wifly-uav/document/装置/ハイスピードカメラ.md

# ハイスピードカメラ

FASTCAM SA3 model 120K-M2の使い方

## インストール

1. [Photronのページ](https://photron.com/photron-support/
)からPFV4をダウンロードする。
Google DriveでもZipでもOneDriveでも良い。
2. ダウンロードしたものがZipの場合、展開する。
3. PFV4_DVDImage(V4.0.6.2)\PFV4_DVDImage(V4.0.6.2)\PFV Setup64を起動する
32bitの場合は、Setup32だが分からない場合はSetup64で良い
windows以外は恐らく不可 
4. 画面に従ってPFV4をインストール
5. ネットワークの設定して再起動

## 撮影手順

1. Boxからカメラとレンズを取り出す
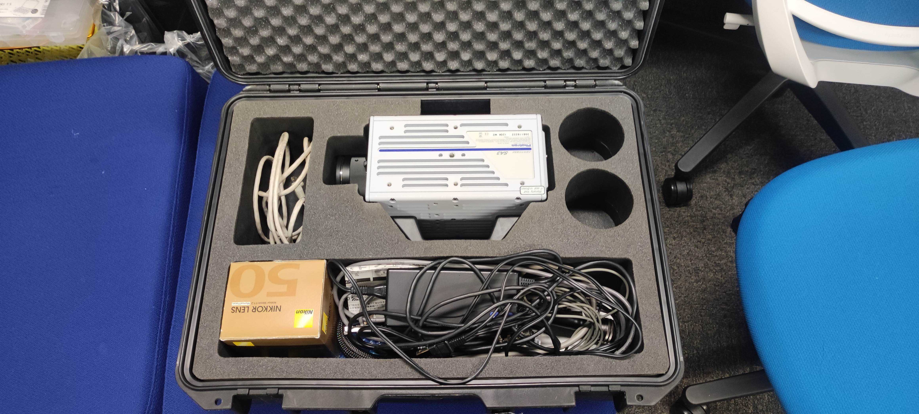
[picture p10: 装置/img/camera_box.jpg]

Boxの開けた状態
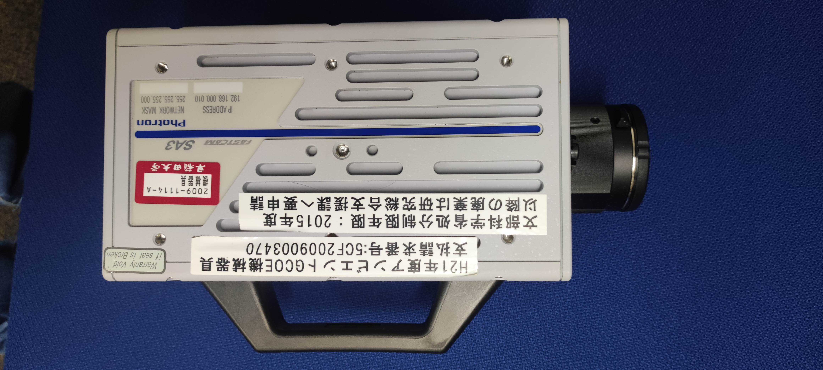
[picture p11: 装置/img/camera_hontai.jpg]

カメラ本体
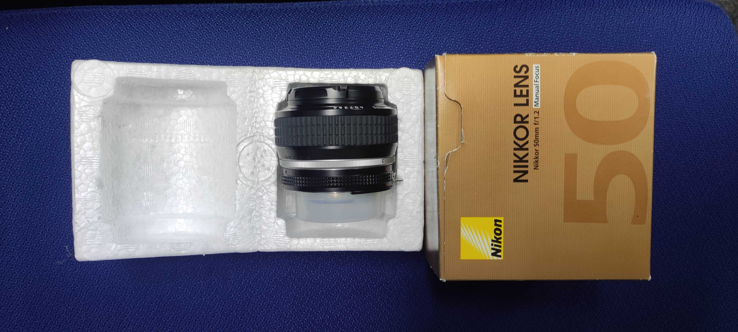
[picture p12: 装置/img/renzu.jpg]

レンズ

2. カメラにレンズを取り付ける
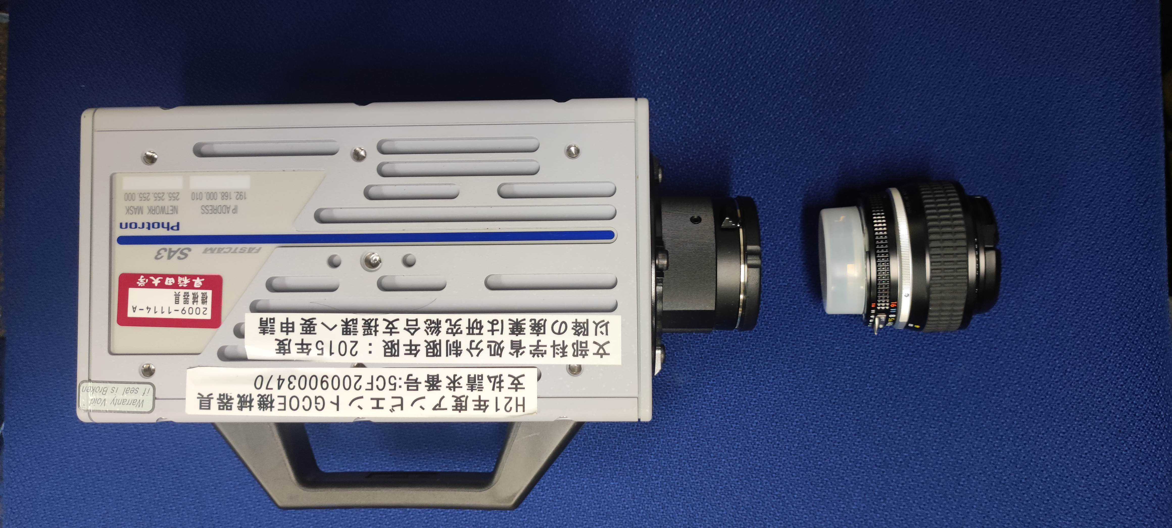
[picture p13: 装置/img/joint.jpg]

まず、レンズ側の白い部分を取り外す。次に、カメラ本体の黒いキャップを外す。最後にレンズをカメラ本体に取り付ける。取り付けるときは回転させてカチッと音が鳴るまで。
**カメラ本体とレンズについてキャップを取り外している状態で中に埃等が入ると使い物にならなくなるので注意**
取り付けると以下のようになる。
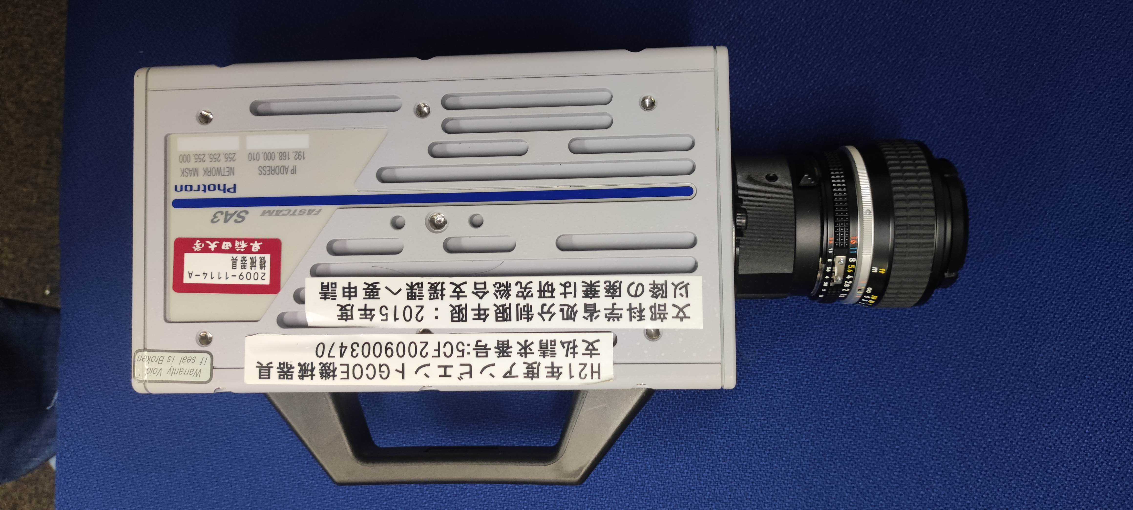
[picture p14: 装置/img/camera.jpg]

レンズを取り外す時はカメラの先端の黒い部分を押しながらレンズを回転させると外すことができる。

3. 設置する
カメラ本体を安定した所に設置する。基本的には、三脚の上に固定をおすすめする。ただし、固定はねじ一本なのでちゃんと固定できたか確認すること。
ハイスピードカメラタカイヨ

4. 配線する
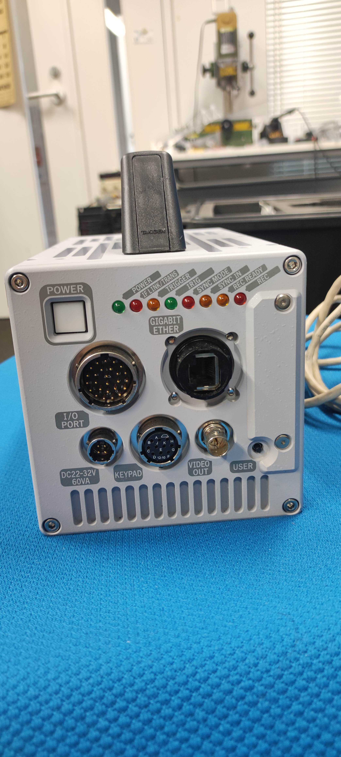
[picture p15: 装置/img/camera_haimen.jpg]

カメラの裏側がこのようになっているので以下のように電源とLANケーブルを配線する。
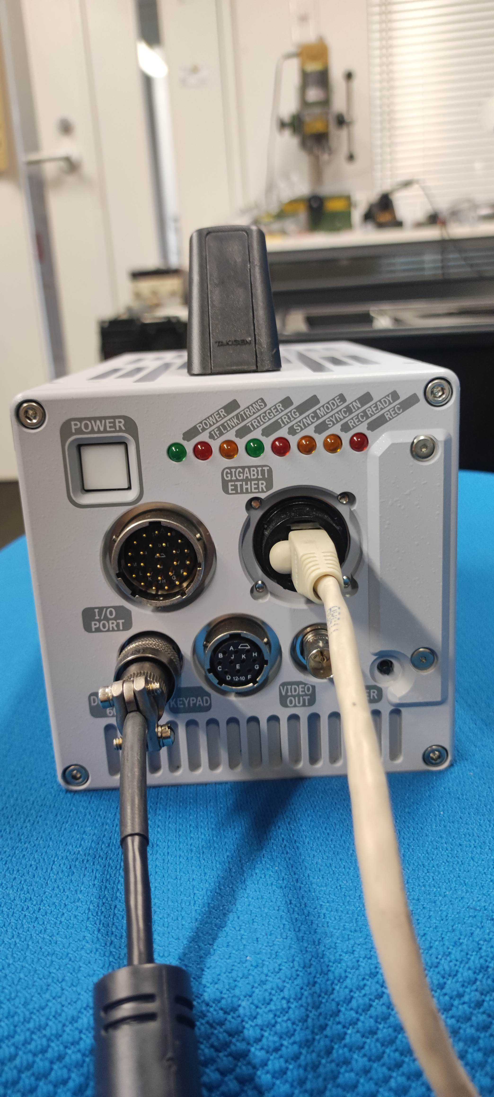
[picture p16: 装置/img/camera_haisen.jpg]


5. カメラの電源を付ける
背面左上の白いボタンを押すと電源が入る。電源を入れておくとカメラ本体が徐々に熱くなっていくので注意。

6. LANケーブルをパソコンに接続する
7. PFV4を起動する
起動した際にカメラが見つからないといった内容のエラーが出てくることがある。その場合は、エラー画面からネットワーク最適化を開く。
192.168.0.1
255.255.255.0
(たぶん最初からこの値が入ってる)
でイーサネットに割り当てを行う。
その後、PFV4を再起動するとちゃんと起動できる。
起動すると以下のような画面になる。
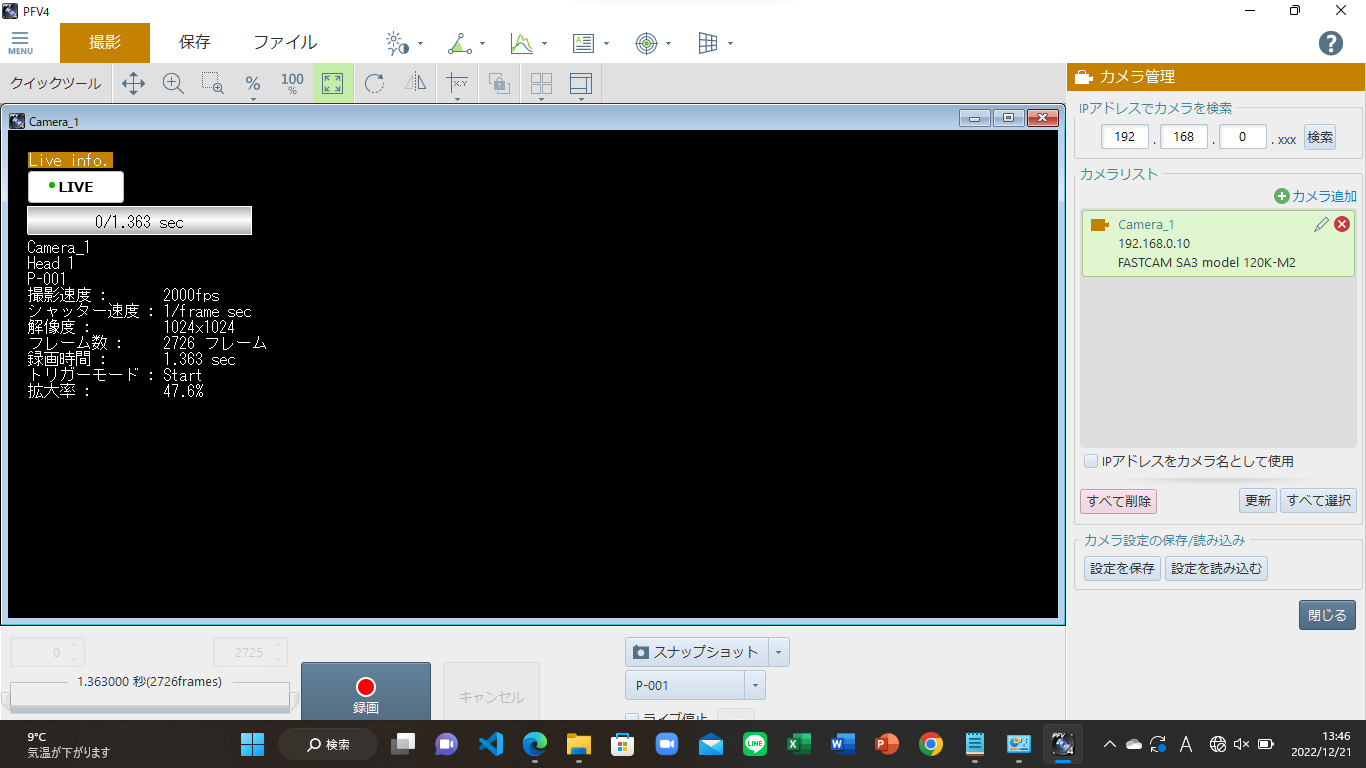
[picture p17: 装置/img/camera_home.png]

ハイスピードカメラを使用後、LANケーブルを使ってインターネットに繋ごうとするとエラーが起きることがある。その時は、windows画面右下のインターネット接続状況を表すアイコンを右クリックし、修復を行うことでインターネットに接続できるようになる。

8. カメラのレンズに付いてるキャップを取り外す
レンズをいじってピントと明るさを調整する。明るさはMAXで良い。

9. 撮影する
画面右下の録画を押すと以下のような待機画面になる。
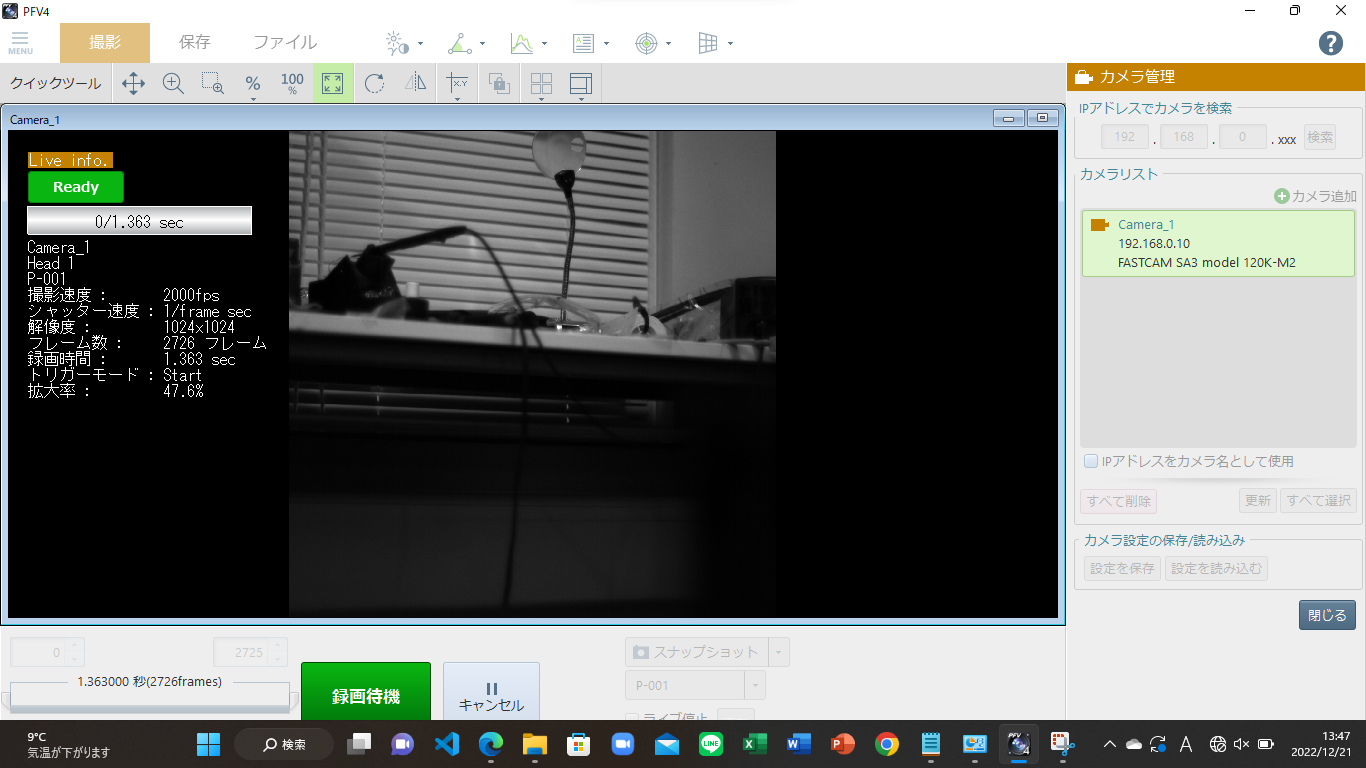
[picture p18: 装置/img/capture2.png]

この状態から右下の録画待機ボタンを押すと撮影できる。
初期設定では、恐らく3秒間撮影される。基本的に3秒以上は撮影できず、それ以上撮影したい場合は解像度を落とせば良い......はず。

10. 保存する
撮影が終了すると自動的に以下のような画面になる。
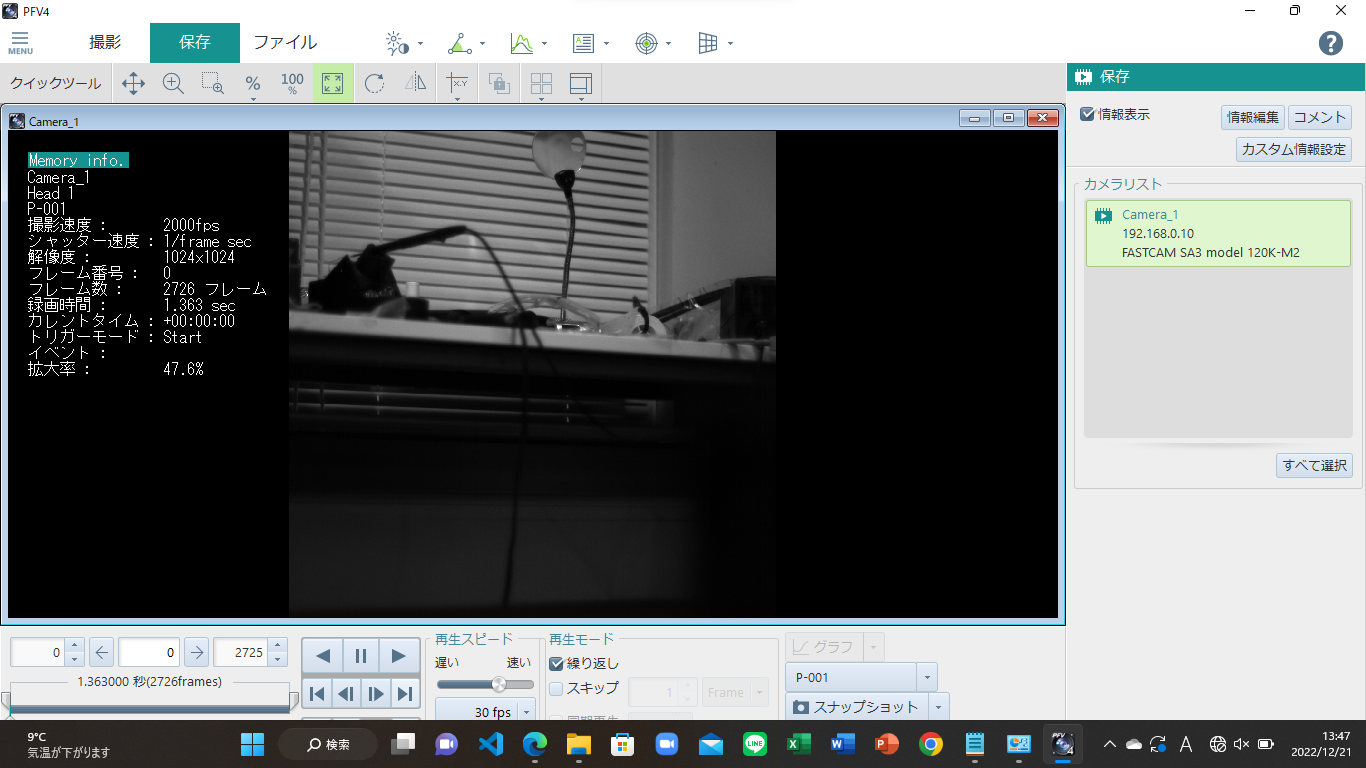
[picture p19: 装置/img/capture1.png]

この画面で操作すると撮影した動画を再生できる。保存したいときは右下（このキャプチャだとタスクバーで隠れてる）のボタンを押す。
ボタンを押すと以下のような画面が出てくる。
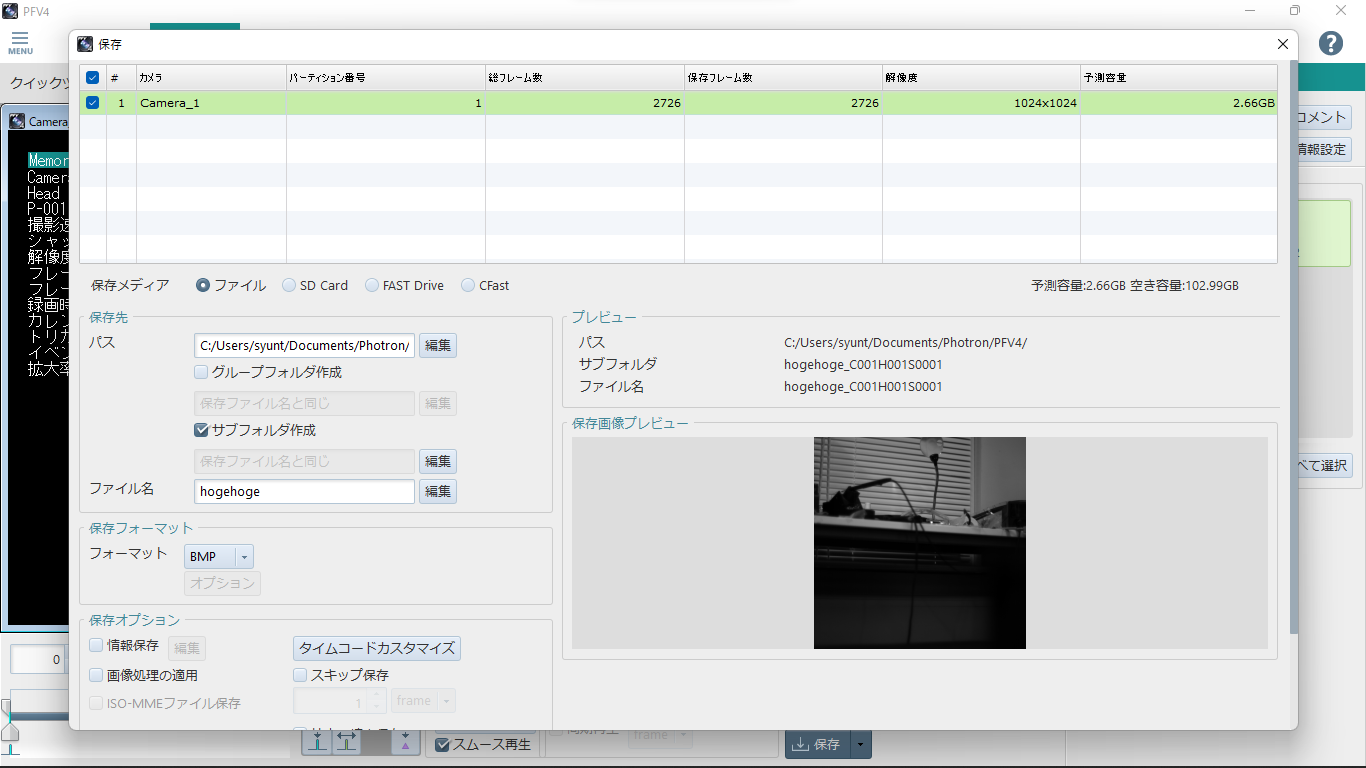
[picture p20: 装置/img/save1.png]

左側のパスの所に保存される。また、ファイル名はその下で指定できる。一回の撮影で2,3GB必要なので注意。下にスクロールしていくとボタンがあるのでそれを押すと保存できる。保存には30秒ぐらいかかる。
保存したあと再度撮影したい場合は、再生画面の左上から撮影タブを押すと再度撮影することができる。

11. アップロードについて
そのままのデータだと数GBになるのでなるべく圧縮してからアップロードしてほしい。圧縮の方法は任せるが、自分はAviutlというソフトを使った。
