wifly-uav/document/画像処理/カメラ付マイコン.md

# カメラ付きマイコン

使用経験があるのは
- ESP32-CAM
- ESP-EYE

それ以外だとマイコンとカメラを別々に購入し、繋ぐ必要がある。

## ESP32-CAM
Ai-Thinker社製マイコン。恐らく、カメラ付きマイコンとしては、一番有名。AmazonやAliexpressで購入可能。ただし、技適認証がないので**電波を出してはいけない** 。
機体に搭載するならWiFiで無線通信が必要になるので使ってはいけない。**ダメ！絶対！**
もし、使いたいなら2つの方法がある。
1. 総務省に申請する
[ここから](https://www.tele.soumu.go.jp/j/sys/others/exp-sp/)webで申請できるらしい。恐らく、秘書（野本さん）にお願いする形になると思う。もし申請する場合は、180日で廃止届出などが必要らしいので必ず確認して。
2. 搭載しているマイコンを付け替える
無線を飛ばしているのは、マイコンなので技適証明があるマイコンに付け替えれば問題なく使える。[ここ](https://claypier.com/esp32-cam-ex-giteki/)を参考にしてほしい。

### 特徴
- OV2640の2MPカメラを搭載している。
- いくつかのペリフェラル（ピン）があり、サーボ等の制御も可能
- プログラムを書き込む際には、別途シリアル変換機が必要

### 使った所感
使い方は、無線カメラ環境構築を参照。
内部レギュレータがAMS1117であり、ドロップアウト電圧が1.0Vである。リポバッテリー(4.2V)だと4.2-1.0=3.2であり、3.3Vを下回ってるはずなのになぜか動いている。動作電圧に達していないこともあり、機体に搭載しているマイコンと同じリポバッテリーに繋いだところ動作しなかったらしい。これは、モーターによって電圧降下が起きていたためと考えられる。バッテリーの消耗は激しくなるが、機体のセンサー用のピンに3.3V電源が出ているのでこれを繋げば恐らく動く。
動かしてみた時は、SVGA(800x600)サイズで数fpsだったと思う。また、動作は安定せず数秒間画像が送られてこないことが多かった。さらにカメラモジュールの接触が悪く、カメラのフレキシブルケーブルを何度も入れなおした。

## ESP-EYE
Espressif社製マイコン。技適認証があるESP32-CAM。秋月で購入可能。

### 特徴
- OV2640の2MPカメラを搭載している。
- ペリフェラル(ピン)が外部に出ていないため、カメラ以外には使えない
- シリアル変換器が搭載されているため、USBを差せばプログラムを書き込むことができる
- 高い

### 所感
内部レギュレータはRT9011(V~dropout~ 240mV)とSMG2205(V~dropout~ 120mV)が使われているので恐らく1sのリポバッテリーで動作できる。その他は、ESP32-CAMと同じ

## カメラモジュール
一応、カメラモジュールのみを購入し、マイコンと繋ぐことも可能。ただし、OV2640を買うと10本以上配線することになる。もし買うならFIFO付きかシリアル出力のカメラモジュールを買うことをおススメする。[秋月の小型TTLカメラ](https://akizukidenshi.com/catalog/g/gM-07746/)を購入してみたが、撮影した画像をSDカードに保存するプログラムしかなくwebカメラ化のプログラムは2つほど見つけたが上手くいかなかった。
