wifly-uav/document/画像処理/画像処理概要.md

# 画像処理概要

## 渡邉研の先行研究と歴史

- 2016年
  - 臼田さん修論(線分SLAM)
- 2017年
  - 安部さん修論(実環境+線分SLAM)
- 2018年
  - 中野さん修論(物体認識+線分SLAM)
- 2019年
  - 西野さん修論(青色認識)
  - 勝山さん卒論(ORB-SLAM)
- 2021年
  - 勝山さん修論(赤色認識+追従)

2018年までは線分SLAMについて研究していた。SLAMというのは、複数の画像(動画)からマッピングを行い、自分の位置を推定する技術の事。線分SLAMは他のSLAMよりも処理が軽いという特徴がある。安部さんまでは良くわからない。中野さんの研究では、物体認識の誤検知が多かったらしい。2019年では、技術の引継ぎが出来なかったため、SLAMは行っていない。線分SLAMのプログラムは使用しているライブラリのバージョンが低く、環境構築が大変なため再現はしていない。また、当時はPCのスペックが低くより処理が軽いSLAMが求められたが現在はPCのスペックが高くなっているためあまり線分SLAMをやるメリットがないと思う。2019年の西野さんの修論は読む価値はない。勝山さんの卒論はgithubに落ちていたORB-SLAMをドローンに乗せて動かしただけ。
