wifly-uav/document/機体/ギアについて.md

# ギア

詳細を知りたければ[ここ](http://www.ecs.shimane-u.ac.jp/~shutingli/ME7.pdf)見て勉強して

## 種類
- 平ギア
- クラッチ付ギア
- 傘型歯車
- 遊星ギア
- デファレンシャルギア
- ラック

UAVでは、平ギア以外は使わなそう。
平ギアは、一般的に想像されるギア。
クラッチ付ギアは大きな力がかかったときに空転できる構造の平ギア。タミヤで売っているが、空転時の力の閾値の設定ができない。
傘型歯車は、傘の形になっている立体的なギア。軸を直角に曲げることができる。軸の固定と伝達効率の低さがデメリット。
遊ギアは、平ギアを組み合わせたもの。モーターの軸と回転する軸を同一直線
上に配置できる。ただ、伝達効率が低い。
デファレンシャルギアは、傘型歯車を組み合わせたもの。車に使われている。2軸の回転を1軸の回転で可能にするもの。
ラックはギアではなく、ギヤと一緒に使うもの。ギヤの回転を直線運動に変換することができる。

## 減速比(ギア比)
2つのギアがかみ合っているとき、それぞれのギアの歯の数の比と減速比(ギア比)という。複数のギアが存在するときは、最初のギアに対して最後のギアまでの最終的な比を示す。（例：2段になっている平ギアが複数あり、それぞれ1:3,1:4だと最終的に1:12になる,1段の場合は1:4)
例えば減速比 1:10　の時は、回転速度が1/10になり、トルクがx10になる。ギアを組み合わせることで回転速度とトルクを自由に決めることができる。ただ、ギアの枚数を増やすとバックラッシュという影響が大きくなり、微小な回転が伝達されなくなる。

## モジュール
```math
モジュール＝直径/歯の数
```
で定義される。モジュールは歯の大きさを表していて、同じモジュール数のギア同士しかかみ合わない。ギア同士の距離は、（モジュールx歯の数)2/+（モジュールx歯の数)/2として計算すれば良い。
