wifly-uav/document/機体/羽について.md

# 羽

## 形状
### 設計
現在の形状は、中村さんが設計したもの。そのときのフィーリングで決めたので特に形状に意味はない。
### 試した形状
縦に伸縮させたものを試したが、揚力は上昇しなかった。
Delflyのように角ばった形にしても揚力は上昇しなかった。
いろいろ試したが結局、揚力は上昇しなかった。(2021年のUAVミーティングでやってるはず、無かったらごめん)

## 支脈
細いカーボンロッドや結束バンドの先端を使って支脈を入れて実験を行ったことがある。結論から言うと揚力は変化しなかった。ただ、6軸力覚センサーの波形は変化していたので何か影響があるかも。個人的には、支脈を付けると消費電力が減少していた気がする。
野沢さんの卒論(2018年)でマスキングテープで支脈を作った実験があるので見てみるといいかも。(結果については誤差な気もするけど。)

## 材質
現在は、ポリエステルを使用。自分の代では、変更して実験はしたことがない。
昔は和紙を使っていたと聞いたことがある。あと昔、素材を変えてみたけど揚力は変らなかった...らしい。

## 空力
発生する力については[この論文](https://engineering.purdue.edu/~xdeng/TRO06a.pdf)のⅣ章を参考にしてほしい
