wifly-uav/document/装置/装置一覧.md

# 装置一覧

UAVグループでは、以下の装置を使用している。

## 加工
- 卓上ボール盤
穴を開ける
- リューター
切断・研磨する
- レーザーカッター
切断する

## 作成
- 積層型3Dプリンター x2
- 光造形3Dプリンター
- はんだごて
- グルーガン
- ヒートガン
熱いドライヤーのようなもの

## 測定
- 6軸力覚センサ
力の測定をする
- 風速計
一応、大型の扇風機もある
- オシロスコープ x2
- テスター
- モーションキャプチャー
喜久井町キャンパスに行く必要がある
