wifly-uav/document/装置/解析ツール一覧.md

# 解析ツール

岡本が使用していた解析プログラムの説明
githubのwiflyレポジトリのanalyzeにプログラムがある。
