wifly-uav/document/シミュレーション/シミュレーション概要.md

# シミュレーション概要

分野としては、実環境とシミュレーションの違いをどう埋めるかがよく研究対象になっている
論文ではSim-to-Realが有名

## これまで使用したソフト
- 物理エンジンを使用
  - Unity(PhysX)
  - Pybullet(bullet)
  - Gazebo(ODE)
- 演算を自分で記述
  - Matlab(Simulink)
- 空力を演算
  - Ancyc

## Unity
2020年の岡本の卒論で使用した
ただし、シミュレーションではなく可視化ツールとして使用
中身はC#で記述
物理エンジンでは空力の計算ができないため、制御量と羽ばたきによる推力の関係式を自分で記述する必要がある
githubのsimulationではUnityとPythonでシミュレーションできる
（関係式は2020年の卒論のものを使用、垂直方向のみ）
ML Agentというものも試したもののあまり使い勝手が良くない
試してみたけば以下のサイトを参照すると良い（バージョンごとに微妙に違うので注意）
https://note.com/search?q=from%3A%40npaka%20MLAgents&context=note&mode=search

## Pybullet
2019年の岡本の真空ゼミで使用した
中身はPythonで記述
基本的にはUnityと同じ
機体自体はURDFという形式で記述する必要がある
4足歩行の強化学習の研究で使われていることが多い

## Gazebo
研究室としては未使用
Ubuntu,ROSの環境で使うソフト
研究で使われていることも多い

## MATLAB(Simulink)
2020年の岡本の卒論で使用した
中身はMATLAB言語で記述
Simulinkで運動方程式をすべて記述して使用
MATLABでシミュレーション、Unityで可視化することが多い
詳細は、別のファイルに書く

## Ansys
2021年の李さんの修論(秋卒業)で使用した気がする
空力のシミュレーションができるソフト
羽の形状からどれぐらいの揚力が生まれるか計算していたはず
WiFlyの羽は、形が一定ではないのでちゃんとしたシミュレーションはできていない
