wifly-uav/document/回路/回路改良案.md

# 回路改良案
* 軽量化
* 電圧測定
* モータ増設
* センサ増設
* 製造簡略化
* 動作安定化

## 軽量化
マイコンボード自体を軽量化する
### 方法
* 基板を薄くする
* 再配置で省面積化
* 配線の長さを最適化する
* メインチップを変更する
* ジャイロセンサをオンボードにする

## 電圧測定
バッテリーの電圧を測定する
### 方法
* マイコンのADCピンを使用する
* 電圧測定ICを搭載する

## モータ増設
マイコンに繋げられるモーター/サーボの個数を増やす
### 方法
* マイコンのピン数を増やす
* マイコンのICを増やす

## センサ増設
モーター、高さ等のフィードバックを行う
### 方法
* 赤外線、超音波、気圧センサを増設する
* モーター用に音、振動、回転数等でフィードバックする

## 製造簡略化
製造を簡単にする
### 方法
* 外注
* 片面化
* 配線用ホールを大きくする
* ベタGND無しにする

## 動作安定化
途中で通信が切れたりしないようにする
### 方法
* モーターにコンデンサーを並列でつなぐ
* 電源に電解コンデンサーを追加する
* モーターの駆動回路をHブリッジにする
