wifly-uav/document/シミュレーション/img/adon.png

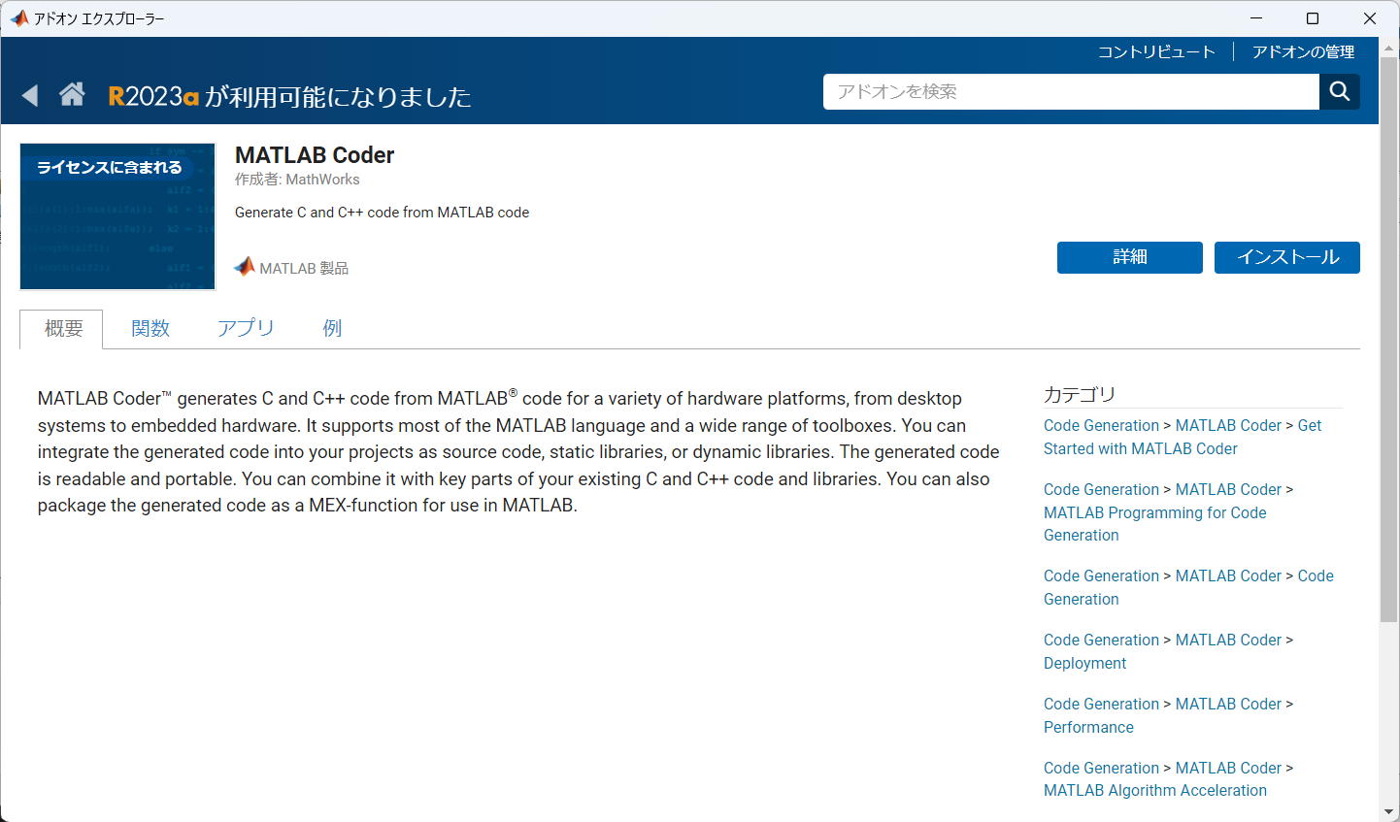
シミュレーション/img/adon.png
