wifly-uav/document/画像処理/img/terminator.png

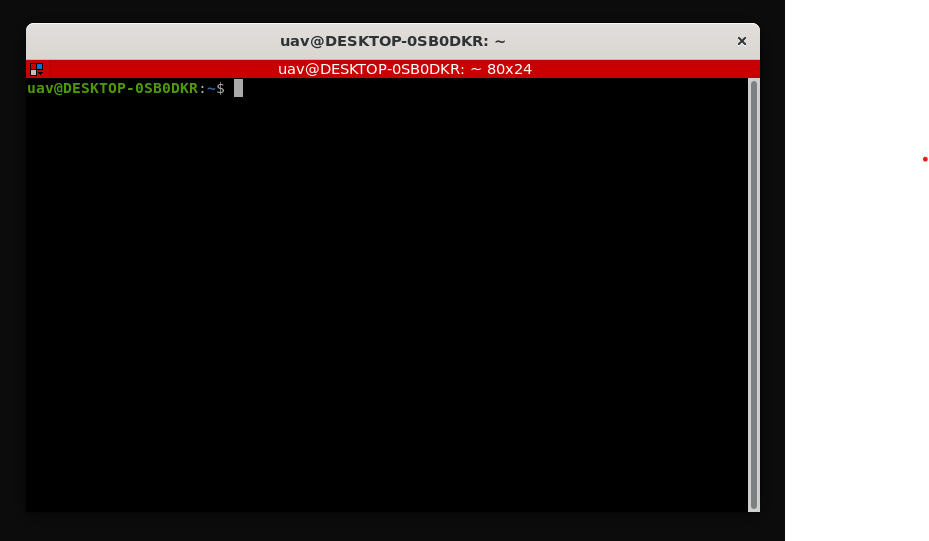
画像処理/img/terminator.png
