wifly-uav/document/画像処理/img/terminator分割.png

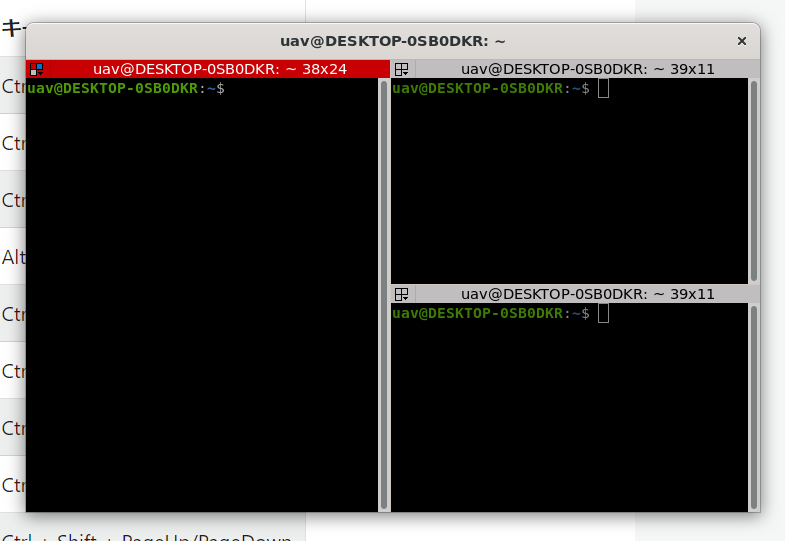
画像処理/img/terminator分割.png
