wifly-uav/document/画像処理/img/Ubuntu起動.png

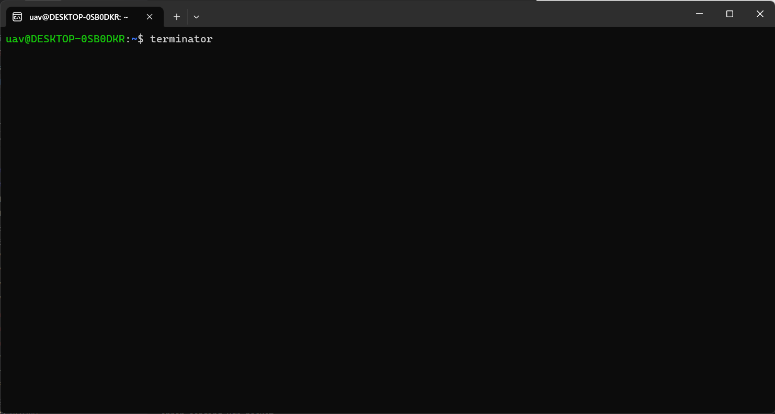
画像処理/img/Ubuntu起動.png
