wifly-uav/document/回路/LTspice/pmw_dcmotor.asc

B1: bv; V=i(R1)*0.0302
B2: bv; V=0.0302*i(R2)
B3: bv; V=i(R1)*0.075/26
L1: ind; 82.3µ
L2: ind; 1.24m
R1: res; 0.3R
R2: res; 5µR
V1: voltage; PULSE(0 24 10u 0u 0u 10u 20u)
Named nets: 0, velocity
.tran 2000us
